phooky/bootarooni/hardware/bootarooni.kicad_pcb

## KiCad design hardware/bootarooni.kicad_pcb (2021-03-08)

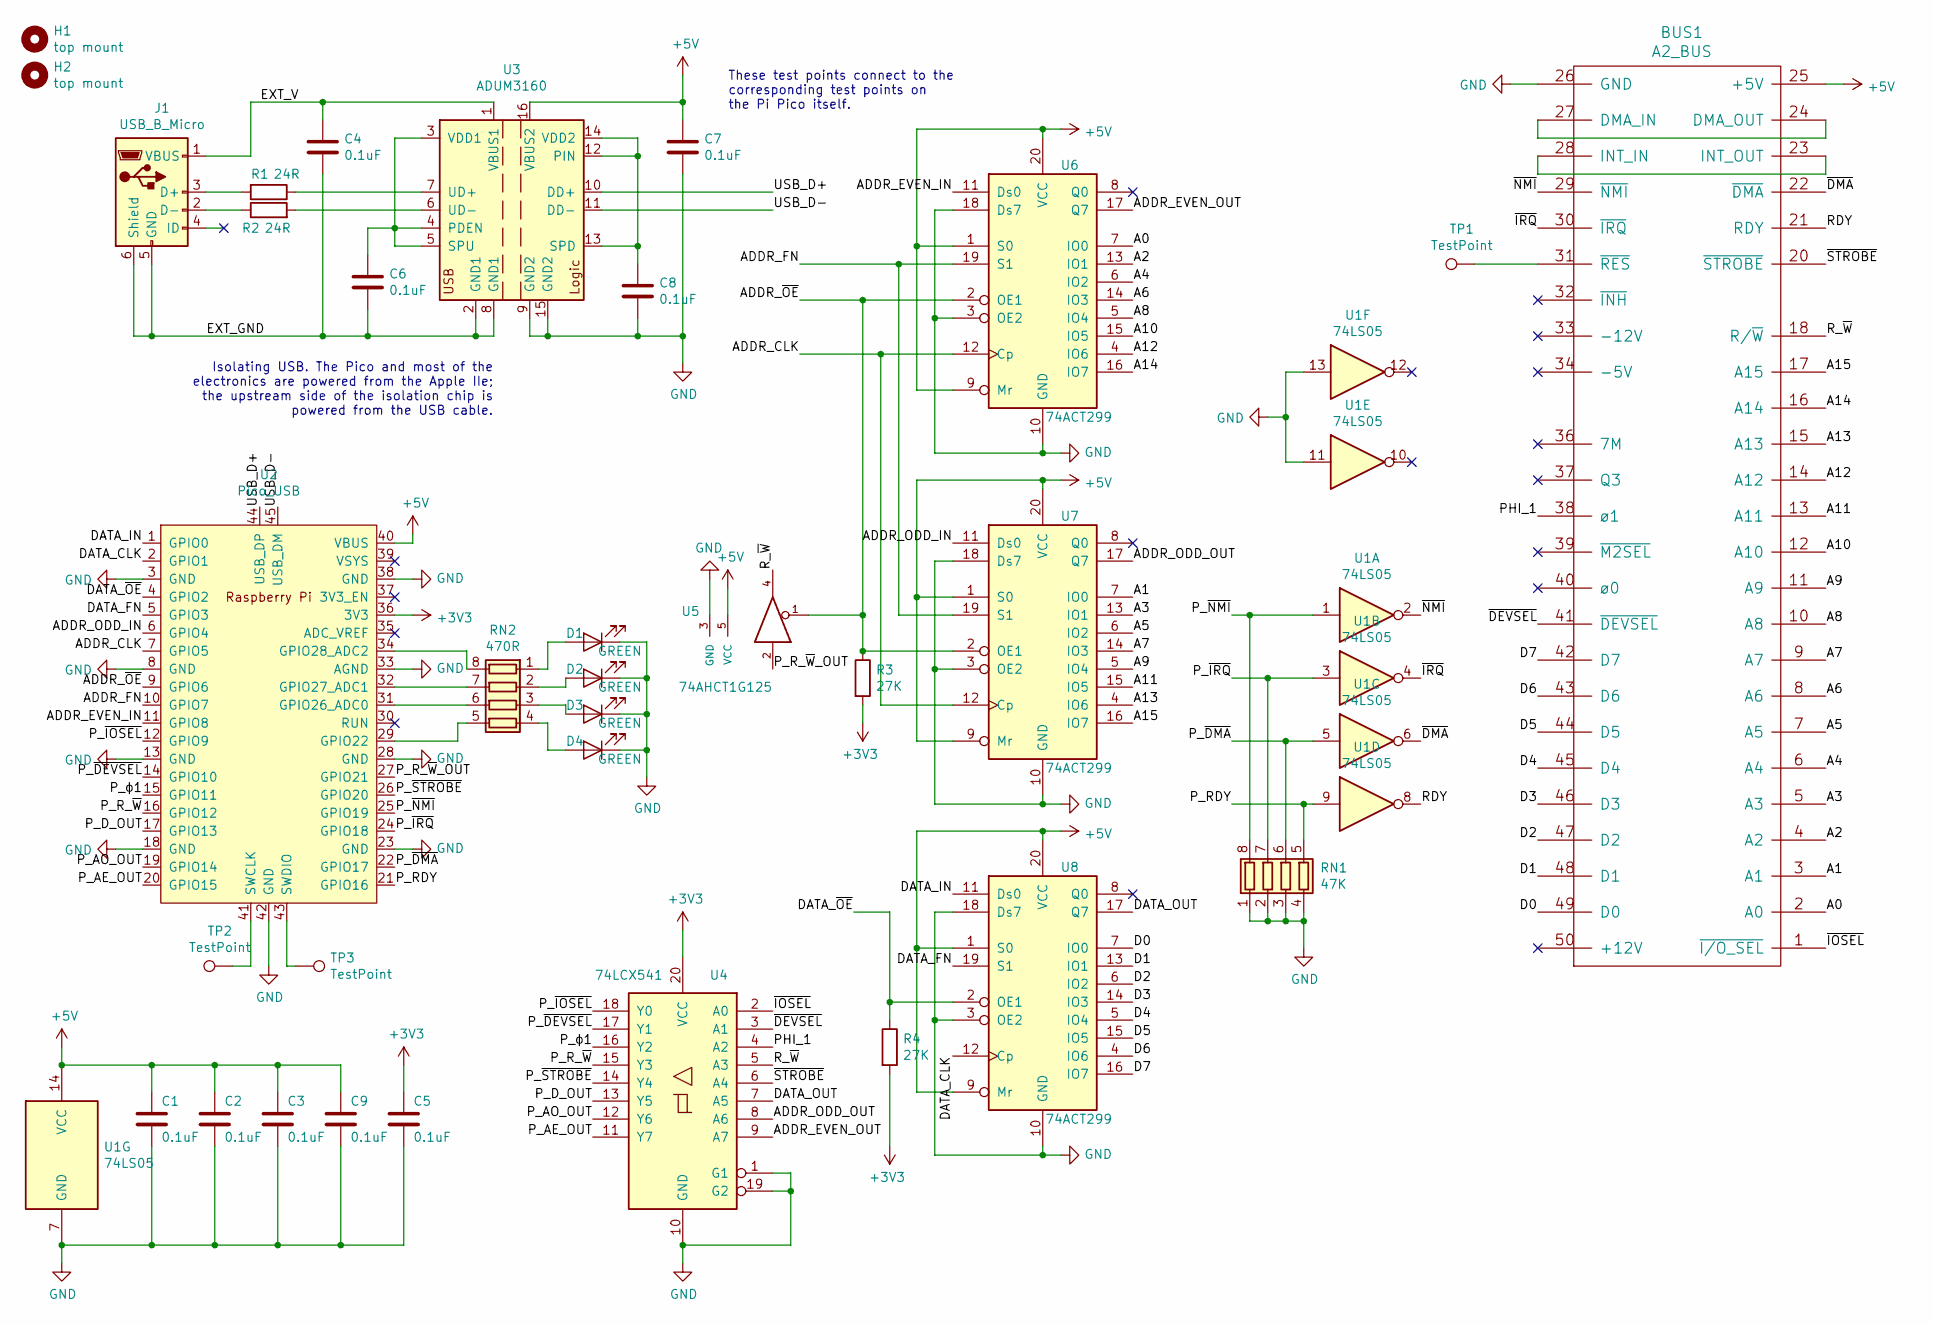
[picture p1: schematic bootarooni.sch]

Parts:
BUS1: A2_BUS; BUS_A2
C1, C2, C3, C4, C5, C6, C7, C8, C9: 0.1uF; C_0805_2012Metric; Digikey P/N 399-8000-1-ND
D1, D2, D3, D4: GREEN; LED_0805_2012Metric; Digikey P/N 160-1423-1-ND
H1, H2: top mount; MountingHole_3.2mm_M3
J1: USB_B_Micro; USB_Micro-B_Amphenol_10103594-0001LF_Horizontal; Digikey P/N 609-4050-1-ND
R1, R2: 24R; R_0805_2012Metric; Digikey P/N P24.0CCT-ND
R3, R4: 27K; R_0805_2012Metric; Digikey P/N P27.0KCCT-ND
RN1: 47K; SOIC-8; Digikey P/N Y10473CT-ND
RN2: 470R; SOIC-8; Digikey P/N Y7471CT-ND
TP1: TestPoint; TestPoint_Pad_D2.0mm
TP2, TP3: TestPoint; TestPoint_Pad_D1.5mm
U1: 74LS05; SOIC-14_3.9x8.7mm_P1.27mm; Digikey P/N 296-1630-1-ND
U2: Pico_USB; RPi_Pico_USB_SMD_TH
U3: ADUM3160; SOIC-16W_7.5x10.3mm_P1.27mm; Digikey P/N ADUM3160BRWZ-RLCT-ND
U4: 74LCX541; SOIC-20W_7.5x12.8mm_P1.27mm; Digikey P/N 74LCX541WMXCT-ND
U5: 74AHCT1G125; SOT-353_SC-70-5; Digikey P/N M74VHC1GT125DF1GOSCT-ND
U6, U7, U8: 74ACT299; SOIC-20W_7.5x12.8mm_P1.27mm; Digikey P/N 296-4277-5-ND

Connections:
+3V3: C5.2, R3.2, R4.2, U2.36 (3V3), U4.20 (VCC)
+5V: BUS1.25 (+5V), C1.2, C2.2, C3.2, C7.1, C9.2, U1.14 (VCC), U2.40 (VBUS), U3.16 (VBUS2), U5.5 (VCC), U6.1 (S0), U6.9 (Mr), U6.20 (VCC), U7.1 (S0), U7.9 (Mr), U7.20 (VCC), U8.1 (S0), U8.9 (Mr), U8.20 (VCC)
/A0: BUS1.2 (A0), U6.7 (IO0)
/A1: BUS1.3 (A1), U7.7 (IO0)
/A2: BUS1.4 (A2), U6.13 (IO1)
/A3: BUS1.5 (A3), U7.13 (IO1)
/A4: BUS1.6 (A4), U6.6 (IO2)
/A5: BUS1.7 (A5), U7.6 (IO2)
/A6: BUS1.8 (A6), U6.14 (IO3)
/A7: BUS1.9 (A7), U7.14 (IO3)
/A8: BUS1.10 (A8), U6.5 (IO4)
/A9: BUS1.11 (A9), U7.5 (IO4)
/A10: BUS1.12 (A10), U6.15 (IO5)
/A11: BUS1.13 (A11), U7.15 (IO5)
/A12: BUS1.14 (A12), U6.4 (IO6)
/A13: BUS1.15 (A13), U7.4 (IO6)
/A14: BUS1.16 (A14), U6.16 (IO7)
/A15: BUS1.17 (A15), U7.16 (IO7)
/ADDR_CLK: U2.7 (GPIO5), U6.12 (Cp), U7.12 (Cp)
/ADDR_EVEN_IN: U2.11 (GPIO8), U6.11 (Ds0)
/ADDR_EVEN_OUT: U4.9 (A7), U6.17 (Q7)
/ADDR_FN: U2.10 (GPIO7), U6.19 (S1), U7.19 (S1)
/ADDR_ODD_IN: U2.6 (GPIO4), U7.11 (Ds0)
/ADDR_ODD_OUT: U4.8 (A6), U7.17 (Q7)
/ADDR_~OE~: R3.1, U2.9 (GPIO6), U5.1, U6.2 (OE1), U7.2 (OE1)
/D0: BUS1.49 (D0), U8.7 (IO0)
/D1: BUS1.48 (D1), U8.13 (IO1)
/D2: BUS1.47 (D2), U8.6 (IO2)
/D3: BUS1.46 (D3), U8.14 (IO3)
/D4: BUS1.45 (D4), U8.5 (IO4)
/D5: BUS1.44 (D5), U8.15 (IO5)
/D6: BUS1.43 (D6), U8.4 (IO6)
/D7: BUS1.42 (D7), U8.16 (IO7)
/DATA_CLK: U2.2 (GPIO1), U8.12 (Cp)
/DATA_FN: U2.5 (GPIO3), U8.19 (S1)
/DATA_IN: U2.1 (GPIO0), U8.11 (Ds0)
/DATA_OUT: U4.7 (A5), U8.17 (Q7)
/DATA_~OE~: R4.1, U2.4 (GPIO2), U8.2 (OE1)
/EXT_GND: C4.2, C6.2, J1.5 (GND), J1.6 (Shield), U3.2 (GND1), U3.8 (GND1)
/EXT_V: C4.1, J1.1 (VBUS), U3.1 (VBUS1)
/PHI_1: BUS1.38 (ø1), U4.4 (A2)
/P_AE_OUT: U2.20 (GPIO15), U4.11 (Y7)
/P_AO_OUT: U2.19 (GPIO14), U4.12 (Y6)
/P_D_OUT: U2.17 (GPIO13), U4.13 (Y5)
/P_RDY: RN1.5 (R4.2), U1.9, U2.21 (GPIO16)
/P_R_~W~: U2.16 (GPIO12), U4.15 (Y3)
/P_R_~W~_OUT: U2.27 (GPIO21), U5.2
/P_~DEVSEL~: U2.14 (GPIO10), U4.17 (Y1)
/P_~DMA~: RN1.6 (R3.2), U1.5, U2.22 (GPIO17)
/P_~IOSEL~: U2.12 (GPIO9), U4.18 (Y0)
/P_~IRQ~: RN1.7 (R2.2), U1.3, U2.24 (GPIO18)
/P_~NMI~: RN1.8 (R1.2), U1.1, U2.25 (GPIO19)
/P_~STROBE~: U2.26 (GPIO20), U4.14 (Y4)
/P_ϕ1: U2.15 (GPIO11), U4.16 (Y2)
/RDY: BUS1.21 (RDY), U1.8
/R_~W~: BUS1.18 (R/~W), U4.5 (A3), U5.4
/USB_D+: U2.44 (USB_DP), U3.10 (DD+)
/USB_D-: U2.45 (USB_DM), U3.11 (DD-)
/~DEVSEL~: BUS1.41 (~DEVSEL), U4.3 (A1)
/~DMA~: BUS1.22 (~DMA), U1.6
/~IOSEL~: BUS1.1 (~I/O_SEL), U4.2 (A0)
/~IRQ~: BUS1.30 (~IRQ), U1.4
/~NMI~: BUS1.29 (~NMI), U1.2
/~STROBE~: BUS1.20 (~STROBE), U4.6 (A4)
GND: BUS1.26 (GND), C1.1, C2.1, C3.1, C5.1, C7.2, C8.2, C9.1, D1.1 (K), D2.1 (K), D3.1 (K), D4.1 (K), RN1.1 (R1.1), RN1.2 (R2.1), RN1.3 (R3.1), RN1.4 (R4.1), U1.7 (GND), U1.11, U1.13, U2.3 (GND), U2.8 (GND), U2.13 (GND), U2.18 (GND), U2.23 (GND), U2.28 (GND), U2.33 (AGND), U2.38 (GND), U2.42 (GND), U3.9 (GND2), U3.15 (GND2), U4.1 (G1), U4.10 (GND), U4.19 (G2), U5.3 (GND), U6.3 (OE2), U6.10 (GND), U6.18 (Ds7), U7.3 (OE2), U7.10 (GND), U7.18 (Ds7), U8.3 (OE2), U8.10 (GND), U8.18 (Ds7)
unnamed: BUS1.23 (INT_OUT), BUS1.28 (INT_IN)
unnamed: BUS1.24 (DMA_OUT), BUS1.27 (DMA_IN)
unnamed: BUS1.31 (~RES), TP1.1
unnamed: C6.1, U3.3 (VDD1), U3.4 (PDEN), U3.5 (SPU)
unnamed: C8.1, U3.12 (PIN), U3.13 (SPD), U3.14 (VDD2)
unnamed: D1.2 (A), RN2.1 (R1.1)
unnamed: D2.2 (A), RN2.2 (R2.1)
unnamed: D3.2 (A), RN2.3 (R3.1)
unnamed: D4.2 (A), RN2.4 (R4.1)
unnamed: J1.2 (D-), R2.1
unnamed: J1.3 (D+), R1.2
unnamed: R1.1, U3.7 (UD+)
unnamed: R2.2, U3.6 (UD-)
unnamed: RN2.5 (R4.2), U2.29 (GPIO22)
unnamed: RN2.6 (R3.2), U2.31 (GPIO26_ADC0)
unnamed: RN2.7 (R2.2), U2.32 (GPIO27_ADC1)
unnamed: RN2.8 (R1.2), U2.34 (GPIO28_ADC2)
unnamed: TP2.1, U2.41 (SWCLK)
unnamed: TP3.1, U2.43 (SWDIO)

Notes on the sheet:
Isolating USB. The Pico and most of the electronics are powered from the Apple IIe; the upstream side of the isolation chip is powered from the USB cable.
These test points connect to the corresponding test points on the Pi Pico itself.

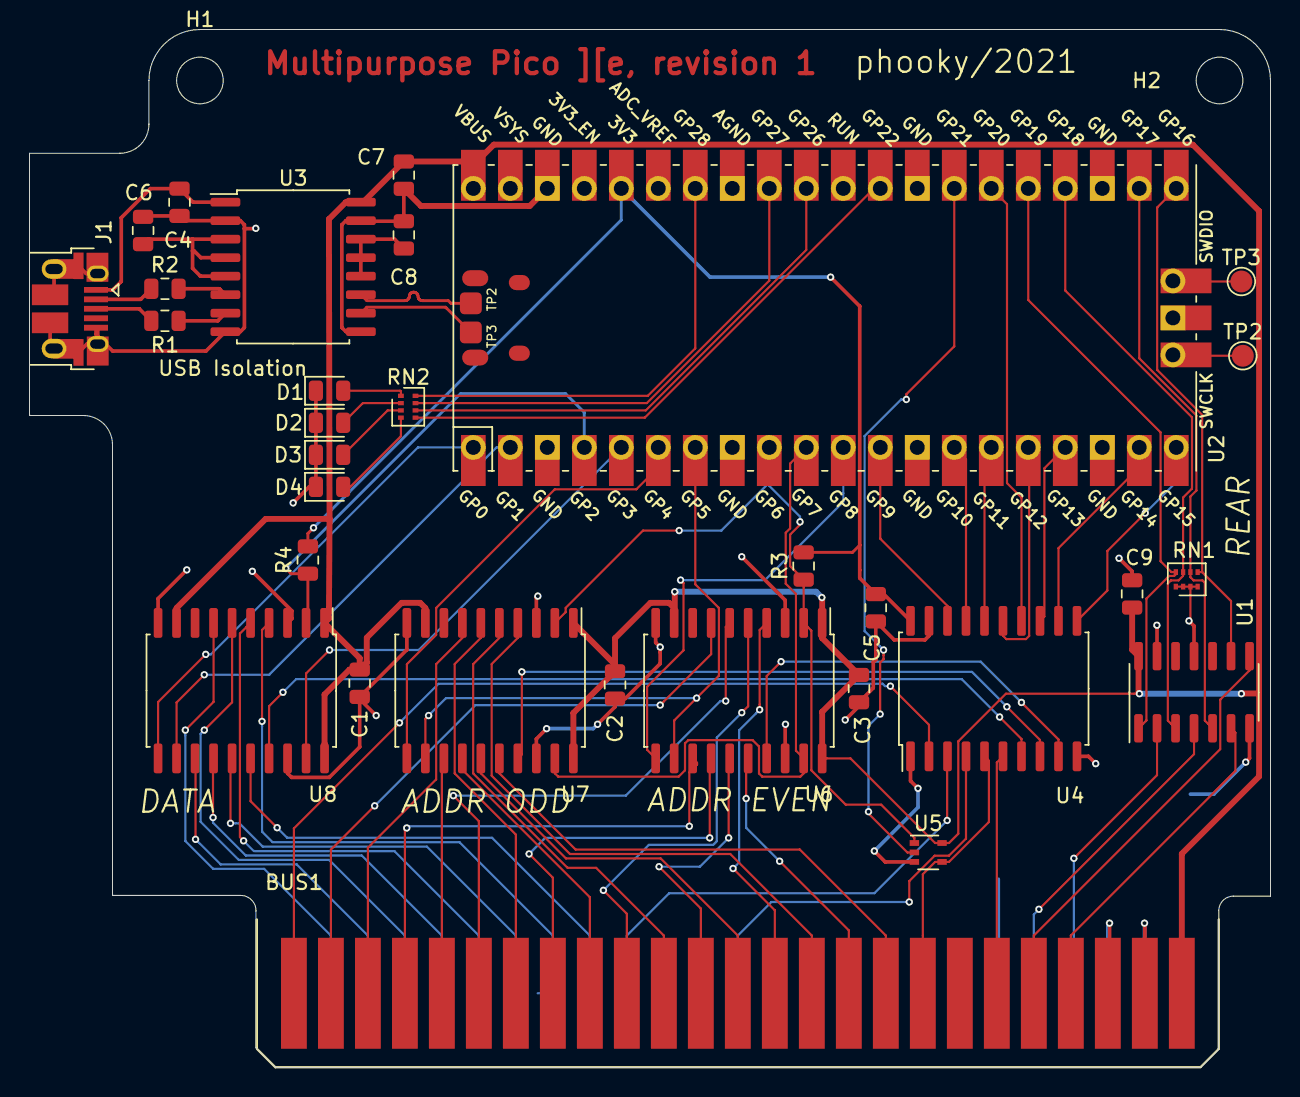
[picture p2: board bootarooni.kicad_pcb from above]

Board: 2 copper layers, 85.2 x 71.2 mm, 34 parts (1 on the bottom side), 84 nets.
