phooky/bootarooni/firmware/A2e_multiboard.c

#include <stdio.h>
#include "pico/stdlib.h"
#include "pico/multicore.h"
#include "pico/bootrom.h"
#include "a2ebus.pio.h"

#define ARRLEN(arr) (sizeof(arr)/sizeof(arr[0]))

typedef uint pin_t;

enum {
    PIN_DATA_IN  = 0,
    PIN_DATA_CLK = 1,
    PIN_DATA_OE  = 2,
    PIN_DATA_FN  = 3,
    PIN_ADDR_ODD_IN  = 4,
    PIN_ADDR_CLK = 5,
    PIN_ADDR_OE  = 6,
    PIN_ADDR_FN  = 7,
    PIN_ADDR_EVEN_IN = 8,
    PIN_IOSEL  = 9,

    PIN_DEVSEL = 10,
    PIN_PHI1   = 11,
    PIN_RW_IN  = 12,
    PIN_DATA_OUT     = 13,
    PIN_ADDR_ODD_OUT  = 14,
    PIN_ADDR_EVEN_OUT = 15,

    PIN_RDY = 16,
    PIN_DMA = 17,
    PIN_IRQ = 18,
    PIN_NMI = 19,

    PIN_STROBE = 20,
    PIN_RW_OUT = 21,
    PIN_LED_0  = 22,
    PIN_LED_1  = 26,
    PIN_LED_2  = 27,
    PIN_LED_3  = 28,
};

const pin_t LED_PINS[] = {
    PIN_LED_0,
    PIN_LED_1,
    PIN_LED_2,
    PIN_LED_3,
};

const size_t LED_PINS_COUNT = ARRLEN(LED_PINS);

/// Initialize a GPIO pin as an output with the given level.
static inline void init_pin(pin_t pin, uint value) {
    gpio_init(pin); 
    gpio_set_dir(pin, GPIO_OUT);
    gpio_put(pin, value);
}

void initialize_gpio() {
    // These pins need to be set immediately; floating or incorrect values
    // will prevent the Apple IIe from booting.
    init_pin(PIN_ADDR_OE,1);
    init_pin(PIN_DATA_OE,1);
    init_pin(PIN_RDY,0);
    init_pin(PIN_DMA,0);
    init_pin(PIN_IRQ,0);
    init_pin(PIN_NMI,0);
    // Set up LED pins.
    init_pin(PIN_LED_0,0);
    init_pin(PIN_LED_1,0);
    init_pin(PIN_LED_2,0);
    init_pin(PIN_LED_3,0);

    // Set up inputs
    gpio_init(PIN_IOSEL);
    gpio_init(PIN_DEVSEL);
    gpio_init(PIN_RW_IN);
    gpio_set_dir(PIN_RW_IN, GPIO_IN);
}

void core1() {
    PIO pio = pio0;
    uint addr_sm = 0;
    uint data_sm = 1;
    uint addr_offset = pio_add_program(pio, &addrbus_program);
    uint data_offset = pio_add_program(pio, &databus_program);
    io_ro_32 *addr_reg = &pio->rxf[addr_sm];
    io_ro_32 *data_reg = &pio->rxf[data_sm];
    init_databus(pio, data_sm, data_offset);
    init_addrbus(pio, addr_sm, addr_offset);
    uint32_t data = 0;
    while (true) {
        while (pio_sm_is_rx_fifo_empty(pio, addr_sm))
            tight_loop_contents();
        uint32_t addr = *addr_reg;
        addr = ((addr & 0xAAAA) >> 1) | ((addr & 0x5555) << 1);
        uint32_t flags = *addr_reg;
        // Offset by 14, so bit 31 = gpio 13, bit 30 = gpio 12, etc
        // Let's compile into 000... IOSEL DEVSEL RW
        // for now let's just isolate RW
        flags = (flags >> 30) & 0x01;
        if (!flags) {
            while (pio_sm_is_rx_fifo_empty(pio, data_sm))
                tight_loop_contents();
            data = *data_reg;
        } else {
            //if (!pio_sm_is_tx_fifo_empty(pio, data_sm)) { data = 0xfe; } // check for buffered stuff
            pio_sm_put(pio, data_sm, data << 24);
        }
        multicore_fifo_push_blocking(addr);
        multicore_fifo_push_blocking(flags);
        multicore_fifo_push_blocking(data);
    }

}

int main()
{
    stdio_init_all();
    initialize_gpio();
    puts("Hello, world!");
    multicore_launch_core1(core1);
    while (true) {
        int c = getchar_timeout_us(2);
        if (c == PICO_ERROR_TIMEOUT) {
            if (multicore_fifo_rvalid()) {
                uint32_t addr = multicore_fifo_pop_blocking();
                printf("Access to address %x\n",addr);
                uint32_t flags = multicore_fifo_pop_blocking();
                if (flags) {
                    // READ, provide value
                    uint32_t data = multicore_fifo_pop_blocking();
                    printf("Reading - (%x).\n",data);
                } else {
                    // WRITE, accept value
                    uint32_t data = multicore_fifo_pop_blocking();
                    printf("Data value %x\n", data);
                }
            }
        } else if (c >= '0' && c <= '9') {
            c -= '0';
        } else if (c >= 'a' && c <= 'f') {
            c -= 'a' - 10;
        } else if (c == 'R') {
            c = -1;
            reset_usb_boot(0,0);
        } else {
            printf("Unrecognized hex digit.\n");
            c = -1; 
        }
        if (c >= 0) {
            printf("Setting LEDs to %x.\n",c);
            for (size_t i = 0; i < LED_PINS_COUNT; i++) {
                gpio_put(LED_PINS[i], (c & (1<<i))?1:0);
            }
        }
    }
    return 0;
}
