phooky/bootarooni/(commit log)

2021-02-26 Initial bootarooni board commit
    [bootarooni.kicad_pcb, bootarooni.sch]
2021-02-26 adding footprints and zeroing in on component values
    [bootarooni.sch]
2021-02-26 fixing up voltage dividers for pull-up footprints for most parts
    [bootarooni.sch]
2021-03-01 Adding some NCs on schematic Rough layout on board
    [bootarooni.kicad_pcb, bootarooni.sch]
2021-03-01 checking in custom footprint for resistor package
2021-03-06 added LEDs, most layout done, need to reroute the power line
    [bootarooni.kicad_pcb, bootarooni.sch]
2021-03-07 initial layout done, needs board edge and mounting holes, along with verification
    [bootarooni.kicad_pcb, bootarooni.sch]
2021-03-07 added mounting holes, board outlines
    [bootarooni.kicad_pcb, bootarooni.sch]
2021-03-08 final v1; board, digikey, and stencil orders submitted
    [bootarooni.kicad_pcb, bootarooni.sch]
2021-03-21 * set LEDs from core0->core1 via fifo
2021-03-22 adding terminal code to reset into bootsel/programming mode
    [A2e_multiboard.c]
2021-03-23 initial pass at PIO code and integration. Haven't been brave enough to switch it on yet.
2021-03-24 update part numbers to 74ACT299
    [bootarooni.sch]
2021-03-26 reorganizing tree
    [bootarooni.kicad_pcb, bootarooni.sch]
2021-04-02 attemping pin read from core1
2021-04-03 soldiering along, finally getting rw bits correctly
    [A2e_multiboard.c]
2021-04-12 well, at least we're currently pushing a whole byte to the data bus, even if it's backwards
2021-04-14 about as far as I'm likely to get with the current model, time to merge and branch anew
